GuillaumeMONTI/project_2stage_OTA/report/config/project_info.tex

% !TeX root = ../report_project_2stage_OTA.tex

% ============================================================
% PROJECT INFORMATION
% ============================================================

\newcommand{\projectname}
{PROJECT 2-STAGE OTA}

\newcommand{\projecttitle}
{Two-Stage OTA Design in SKY130A}

\newcommand{\projectsubtitle}
{Specification-Driven Analog Design from Ideal Architecture to Transistor Level}

\newcommand{\projectpdk}
{SKY130A}

\newcommand{\projecttools}
{Xschem · ngspice · IIC-OSIC-TOOLS}

\newcommand{\projectauthor}
{Guillaume Monti}

\newcommand{\projectrole}
{Analog IC Design Engineer}

\newcommand{\projectrevision}
{0.2}

\newcommand{\projectdate}
{October 2026}

\newcommand{\projectrepo}
{https://github.com/GuillaumeMONTI/project_2stage_OTA}
