GuillaumeMONTI/project_2stage_OTA/report/generated/pvt_summary_table.tex

% AUTO-GENERATED -- DO NOT EDIT

\begin{table}[ht]
    \centering
    \caption{Main electrical performance over the
    45-point PVT matrix at $C_L=4~\mathrm{pF}$.}
    \label{tab:pvt_summary}

    \begin{tabular}{lccc}
        \hline
        Metric & Nominal & Worst PVT & Worst condition \\
        \hline

        DC gain &
        89.7 dB &
        87.6 dB &
        FNSP / $+125^\circ\mathrm{C}$ / 1.62 V \\

        UGF &
        1068 kHz &
        828 kHz &
        FNSP / $+125^\circ\mathrm{C}$ / 1.62 V \\

        Phase margin &
        75.0$^\circ$ &
        64.7$^\circ$ &
        SS / $+125^\circ\mathrm{C}$ / 1.62 V \\

        Gain margin &
        17.9 dB &
        13.8 dB &
        SNFP / $-40^\circ\mathrm{C}$ / 1.98 V \\

        Supply current &
        4.00 $\mu$A &
        4.05 $\mu$A &
        FNSP / $+125^\circ\mathrm{C}$ / 1.98 V \\

        PSRR$^+$ @ 1 kHz &
        99.9 dB &
        53.3 dB &
        SNFP / $-40^\circ\mathrm{C}$ / 1.62 V \\

        \hline
    \end{tabular}
\end{table}
