GuillaumeMONTI/project_2stage_OTA/report/backmatter/appendices.tex

% !TeX root = ../report_project_2stage_OTA.tex

\clearpage

\appendix

\section{Additional Simulation Results}
\label{app:additional_results}

This appendix contains additional simulation results that are useful
for completeness but are not required in the main design discussion.

\section{Complete Schematics}
\label{app:schematics}

Large or complete schematics can be provided here without interrupting
the main engineering narrative.
