GuillaumeMONTI/project_2stage_OTA/report/backmatter/references.tex

% !TeX root = ../report_project_2stage_OTA.tex

\clearpage

\printbibliography[
    heading=bibintoc,
    title={References}
]
