GuillaumeMONTI/project_2stage_OTA/report/frontmatter/titlepage.tex

% !TeX root = ../report_project_2stage_OTA.tex

\begin{titlepage}

    \thispagestyle{empty}

    \sffamily
    \color{TextColor}

    % ========================================================
    % TOP IDENTIFICATION
    % ========================================================

    \noindent
    {\small\bfseries\color{AccentColor}
        OPEN ANALOG IC DESIGN
    }

    \hfill

    {\small\color{MutedText}
        \projectpdk
    }

    \vspace{4mm}

    {\color{RuleColor}
        \rule{\textwidth}{0.6pt}
    }

    % ========================================================
    % TITLE BLOCK
    % ========================================================

    \vspace*{0.15\textheight}

    {\Large\bfseries\color{AccentColor}
        \projectname
        \par
    }

    \vspace{6mm}

    {\fontsize{28}{32}\selectfont
        \bfseries
        \projecttitle
        \par
    }

    \vspace{6mm}

    {\large\color{MutedText}
        \projectsubtitle
        \par
    }

    \vspace{10mm}

    {\color{AccentColor}
        \rule{32mm}{1.5pt}
    }

    % ========================================================
    % PROJECT METADATA
    % ========================================================

    \vfill

    \begin{tabularx}{\textwidth}{@{}l X@{}}

        \textcolor{MutedText}{PDK}
        &
        \projectpdk
        \\[2.5mm]

        \textcolor{MutedText}{Tools}
        &
        \projecttools
        \\[2.5mm]

        \textcolor{MutedText}{Revision}
        &
        \projectrevision
        \\[2.5mm]

        \textcolor{MutedText}{Date}
        &
        \projectdate
        \\[2.5mm]

        \textcolor{MutedText}{Repository}
	&
	\href{\projectrepo}{GitHub repository}

    \end{tabularx}

    % ========================================================
    % AUTHOR
    % ========================================================

    \vspace{14mm}

    {\color{RuleColor}
        \rule{\textwidth}{0.6pt}
    }

    \vspace{5mm}

    \noindent
    {\bfseries\projectauthor}

    \hfill

    {\color{MutedText}
        \projectrole
    }

\end{titlepage}
