GuillaumeMONTI/project_2stage_OTA/report/frontmatter/toc.tex

% !TeX root = ../report_project_2stage_OTA.tex

\thispagestyle{frontmatter}

{\sffamily\small\bfseries\color{AccentColor}
    DOCUMENT STRUCTURE
}

\vspace{3mm}

{\color{RuleColor}
    \rule{\textwidth}{0.6pt}
}

\vspace{8mm}

\tableofcontents
