GuillaumeMONTI/project_2stage_OTA/report/figures/montecarlo/mc_vos_nominal.pdf

−3 | −2 | −1 | 0 | 1 | 2 | 3
Input-referred offset VOS [mV]

0

5

10

15

20

25

30

Samples

### Monte Carlo -- VDD = 1.8 V, T = 27

∘C
μ = 0.04 mV
μ ± 3σ = 3.33 mV
