GuillaumeMONTI/project_2stage_OTA/report/figures/montecarlo/baseline/mc_gain_nominal.pdf

80.0 | 80.5 | 81.0 | 81.5 | 82.0 | 82.5 | 83.0
DC open-loop gain A0 [dB]

0

5

10

15

20

25

Samples

### Monte Carlo -- VDD = 1.8 V, T = 27

∘C

μ = 82.51 dB
3σ = 0.35 dB 80 dB requirement
