GuillaumeMONTI/project_2stage_OTA/report/figures/montecarlo/baseline/mc_vos_nominal.pdf

−20 | −15 | −10 | −5 | 0 | 5 | 10 | 15
Input-referred offset VOS [mV]

0

5

10

15

20

25

Samples

### Monte Carlo -- VDD = 1.8 V, T = 27

∘C
μ = -0.17 mV
μ ± 3σ = 18.37 mV
