GuillaumeMONTI/project_2stage_OTA/report/generated/transistor_ac_comp_table.tex

% AUTO-GENERATED -- DO NOT EDIT

\begin{table}[ht]
    \centering
    \caption{Final transistor-level compensation study at
    $C_L=4~\mathrm{pF}$.}
    \label{tab:transistor_compensation}

    \begin{tabular}{lccc}
        \hline

        $R_{\mathrm{MILLER}}$
        & DC gain
        & UGF
        & Phase margin \\

        \hline

        Short reference
        & 89.7 dB
        & 863.2 kHz
        & $42.5^\circ$ \\

        19 k$\Omega$ physical
        & 89.7 dB
        & 863.9 kHz
        & $46.8^\circ$ \\

        110 k$\Omega$ physical
        & 89.7 dB
        & 925.4 kHz
        & $64.7^\circ$ \\

        180 k$\Omega$ physical (selected)
        & 89.7 dB
        & 1067.6 kHz
        & $75.0^\circ$ \\

        \hline
    \end{tabular}
\end{table}
