GuillaumeMONTI/project_2stage_OTA/report/figures/transistor/ac/transistor_ac_load_comparison.pdf

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

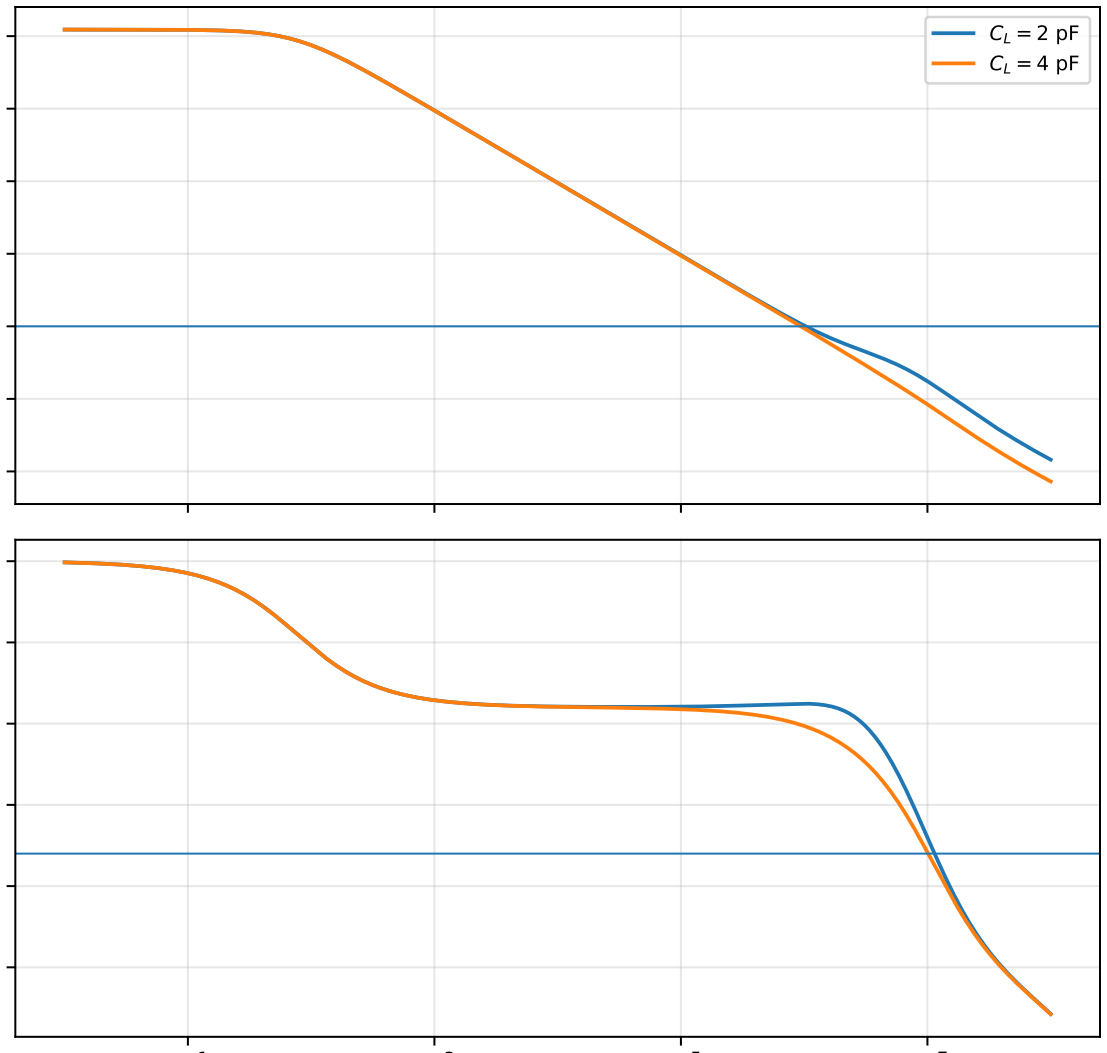
[picture p7: figure]
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
