GuillaumeMONTI/project_2stage_OTA/report/figures/transistor/ac/transistor_ac_compensation_comparison.pdf

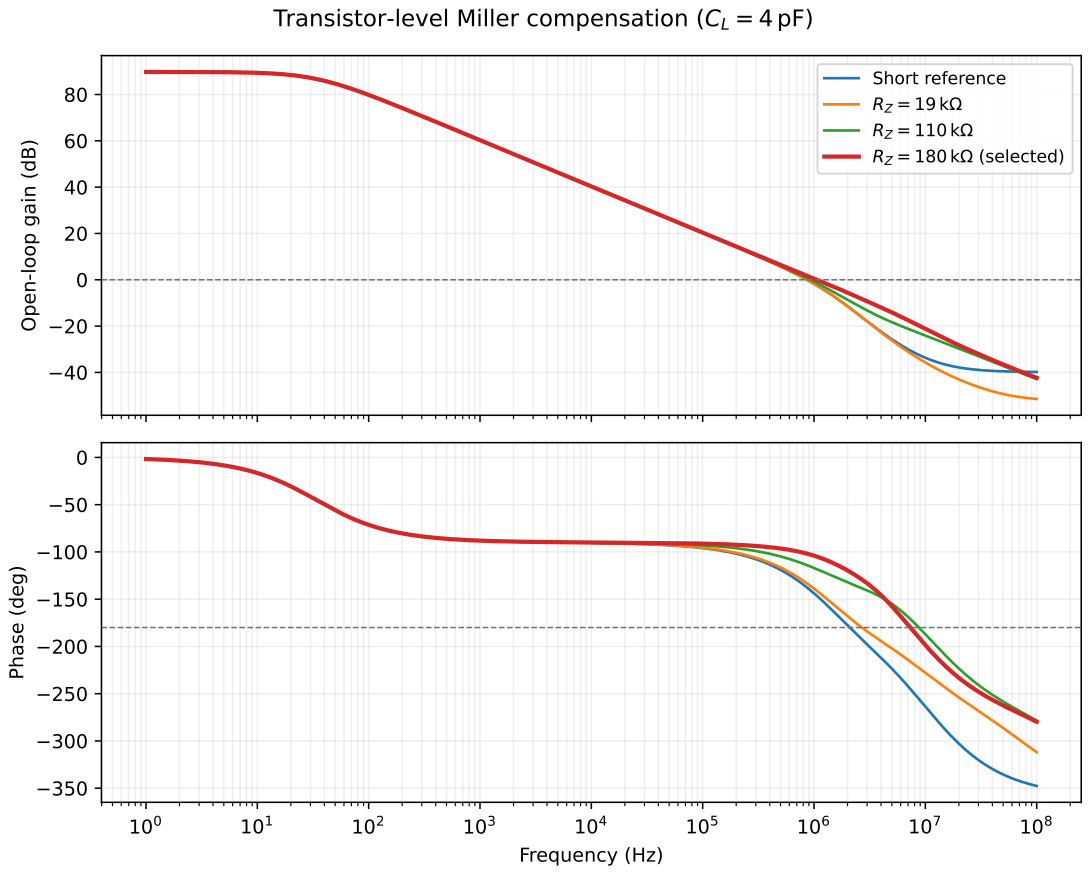
[picture p8: page 1]
Frequency (Hz); Phase (deg)

Transistor-level Miller compensation (CL = 4 pF)

Short reference
RZ = 19 kΩ RZ = 110 kΩ

Open-loop gain (dB)

RZ = 180 kΩ (selected)
