GuillaumeMONTI/project_2stage_OTA/report/figures/transistor/schematics/ota_2stage_transistor.pdf

## VDD

1 | : | 1 | : | 6

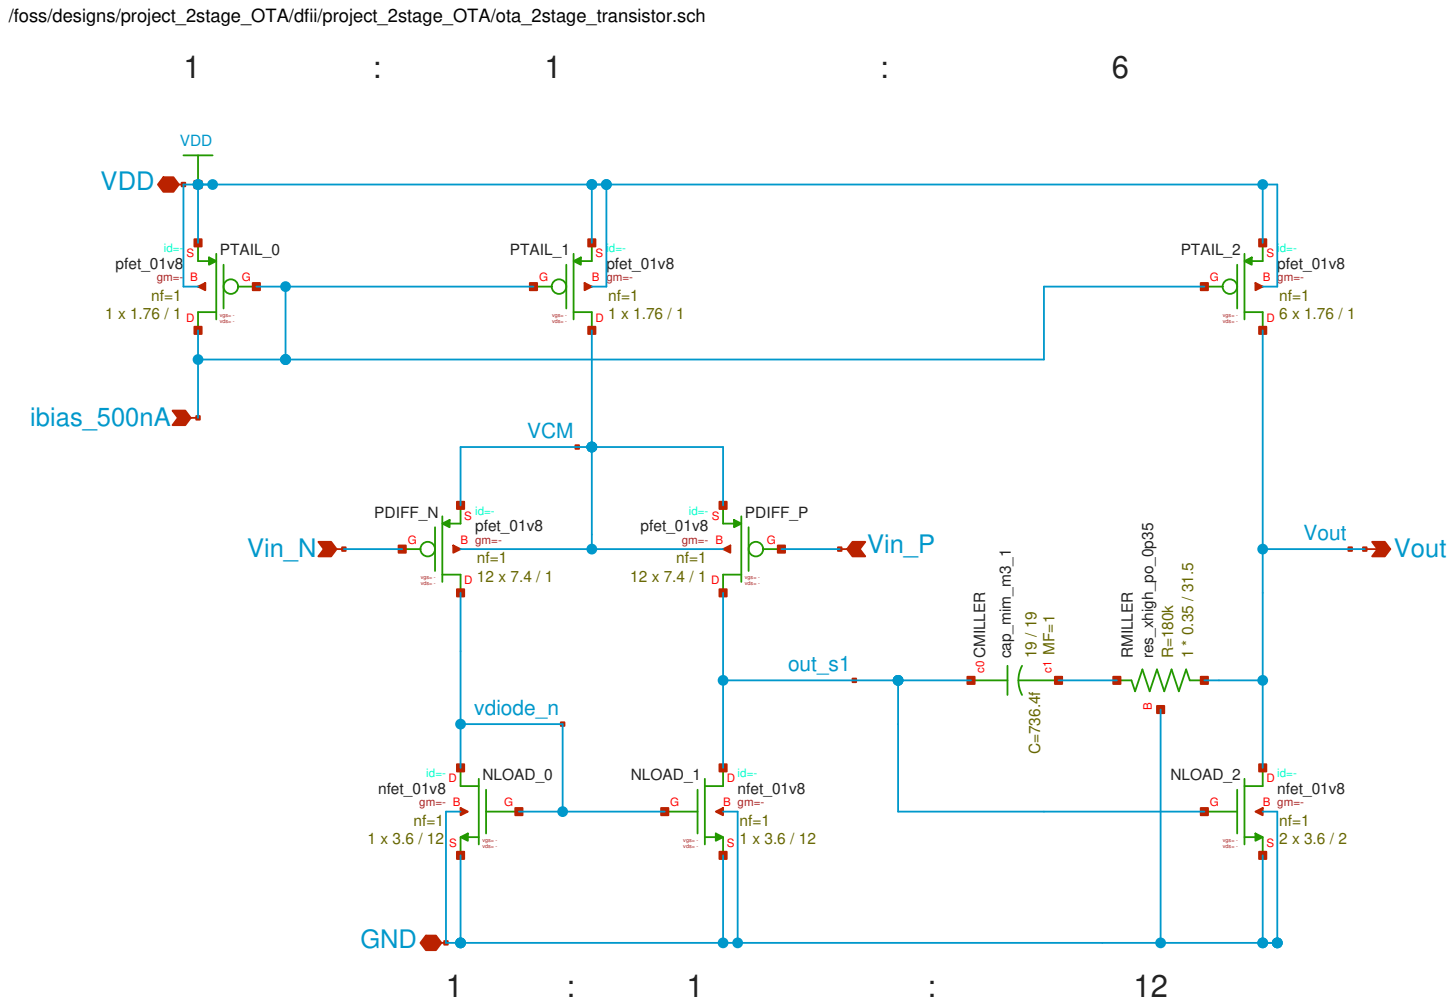
[picture p9: page 1]
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

/foss/designs/project_2stage_OTA/dfii/project_2stage_OTA/ota_2stage_transistor.sch
