GuillaumeMONTI/project_2stage_OTA/report/figures/ideal/ac/ideal_ac_compensation_comparison.pdf

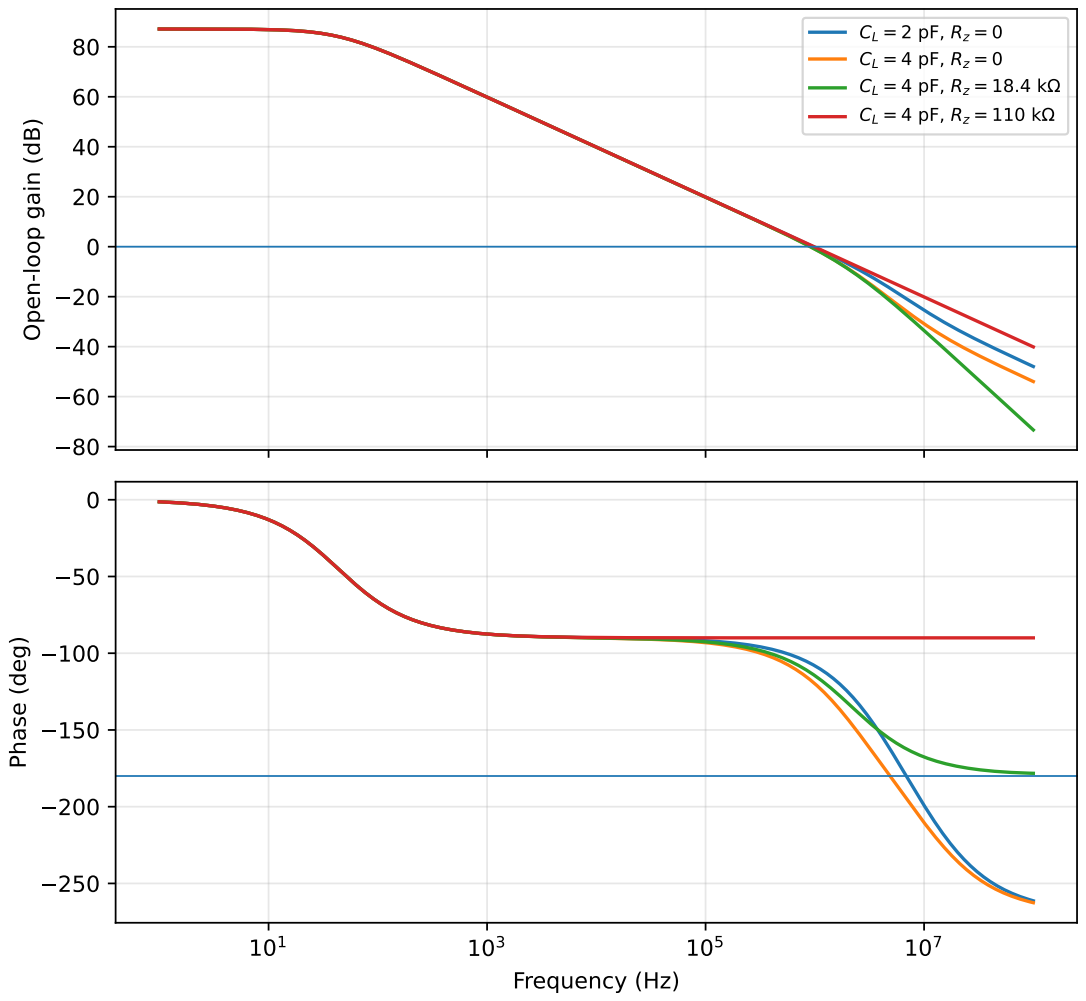
[picture p10: page 1]
Frequency (Hz); Phase (deg)

C = 2 p L | F , R = 0 z
C = 4 p L | F , R = 0 z F , R = 1 8 . 4 k z

Open-loop gain (dB)
