GuillaumeMONTI/project_2stage_OTA/(commit log)

2026-09-16 Initialize two-stage OTA project
2026-09-19 Add first-order OTA design and ideal compensation study
    [ota_2stage_Pdiff_pair.sch, ota_2stage_ideal.sch, tb_ota_2stage_ideal_ac.sch]
2026-10-09 Complete OTA schematic characterization and update report
